JanusErasmus/io_niode/Firmware/readme.md

# IO Node Firmware

## Building it
  - Import this project into [STM32CubeIDE](https://www.st.com/en/development-tools/stm32cubeide.html)
  - Build and load to board using  
    - [stm32flash loader](https://git.code.sf.net/p/stm32flash/code)  
or
    - [STM32CubeProgrammer](https://www.st.com/content/st_com/en/products/development-tools/software-development-tools/stm32-software-development-tools/stm32-programmers/stm32cubeprog.html)
