JanusErasmus/io_niode/Hardware/io_node.kicad_pcb

## KiCad design Hardware/io_node.kicad_pcb (2020-10-30)

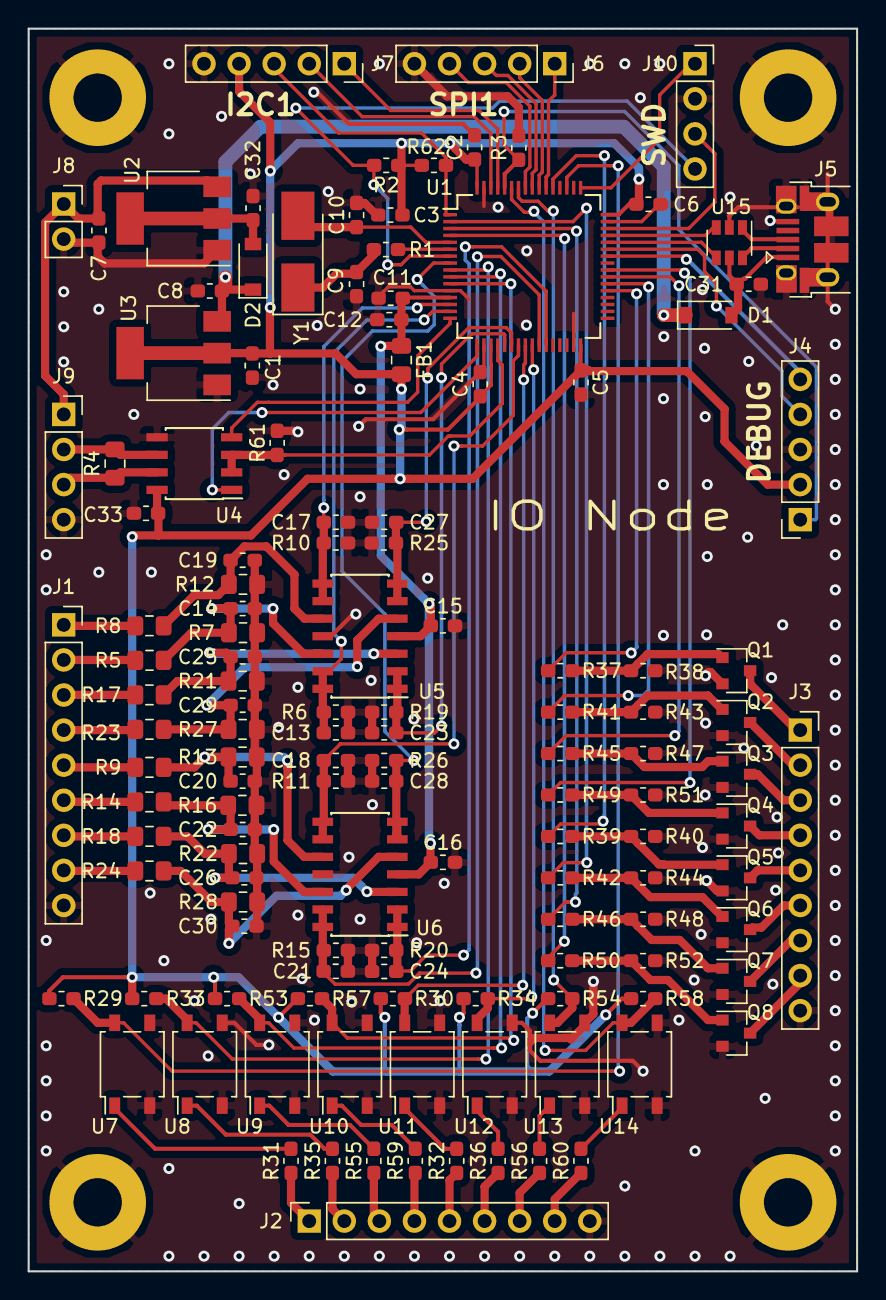
[picture p1: board io_node.kicad_pcb from above]

Board: 2 copper layers, 60.0 x 90.0 mm, 136 parts (0 on the bottom side), 104 nets.

Parts:
C1, C7: 4_7UF; C_0603_1608Metric_Pad1.05x0.95mm_HandSolder
C2, C3, C4, C5, C6, C8, C11, C14, C15, C16, C19, C20, C22, C25, C26, C29, C30, C31, C32, C33: 100NF; C_0603_1608Metric_Pad1.05x0.95mm_HandSolder
C9, C10: 33PF; C_0603_1608Metric_Pad1.05x0.95mm_HandSolder
C12, C13, C17, C18, C21, C23, C24, C27, C28: 1NF; C_0603_1608Metric_Pad1.05x0.95mm_HandSolder
D1, D2: B5819W; D_SOD-123
FB1: 600R; R_0805_2012Metric_Pad1.15x1.40mm_HandSolder
H1, H2, H3, H4: MountingHole_Pad; MountingHole_3.5mm_Pad
J1, J2, J3: Conn_01x09; PinSocket_1x09_P2.54mm_Vertical
J4, J6, J7: Conn_01x05; PinSocket_1x05_P2.54mm_Vertical
J5: USB_B_Micro; USB_Micro-B_Amphenol_10103594-0001LF_Horizontal
J8: Conn_01x02; PinSocket_1x02_P2.54mm_Vertical
J9, J10: Conn_01x04; PinSocket_1x04_P2.54mm_Vertical
Q1, Q2, Q3, Q4, Q5, Q6, Q7, Q8: 2N7002; SOT-23
R1, R31, R32, R35, R36, R55, R56, R59, R60: 470R; R_0603_1608Metric_Pad1.05x0.95mm_HandSolder
R2, R3, R6, R10, R11, R15, R19, R20, R25, R26, R29, R30, R33, R34, R38, R40, R43, R44, R47, R48, R51, R52, R53, R54, R57, R58, R61: 10K; R_0603_1608Metric_Pad1.05x0.95mm_HandSolder
R4: 120R; R_0805_2012Metric_Pad1.15x1.40mm_HandSolder
R5, R7, R8, R9, R12, R13, R14, R16, R17, R18, R21, R22, R23, R24, R27, R28: 10K; R_0805_2012Metric_Pad1.15x1.40mm_HandSolder
R37, R39, R41, R42, R45, R46, R49, R50: 1K; R_0603_1608Metric_Pad1.05x0.95mm_HandSolder
R62: 0R; R_0603_1608Metric_Pad1.05x0.95mm_HandSolder
U1: STM32F103RBT6; LQFP-64_10x10mm_P0.5mm
U2: AMS1117-5.0; SOT-223-3_TabPin2
U3: AMS1117-3.3; SOT-223-3_TabPin2
U4: SP3485EN; SOIC-8_3.9x4.9mm_P1.27mm
U5, U6: LM324DT; SOIC-14_3.9x8.7mm_P1.27mm
U7, U8, U9, U10, U11, U12, U13, U14: EL357N-G; SO-4_4.4x4.3mm_P2.54mm
U15: USBLC6-2SC6; SOT-23-6
Y1: 8 MHz; Crystal_SMD_5032-2Pin_5.0x3.2mm_HandSoldering

Connections:
+3.3VA: C11.1, C12.1, C15.1, C16.1, FB1.1, U1.13, U5.4, U6.4
+3V3: C1.1, C2.1, C3.1, C4.1, C5.1, C6.1, C33.1, FB1.2, J4.2, J7.4, R2.1, R29.1, R30.1, R33.1, R34.1, R53.1, R54.1, R57.1, R58.1, R62.2, U1.19, U1.32, U1.48, U1.64, U3.2, U4.8
+5V: C8.1, D1.1, D2.1, U3.3
+12V: C7.1, J8.1, J9.1, U2.3
+BATT: J7.3, R62.1, U1.1
/ADC_IN0: C17.1, R10.1, U1.14, U5.8, U5.9
/ADC_IN1: C13.1, R6.1, U1.15, U5.13, U5.14
/ADC_IN5: C23.1, R19.1, U1.21, U5.1, U5.2
/ADC_IN6: C27.1, R25.1, U1.22, U5.6, U5.7
/ADC_IN7: C18.1, R11.1, U1.23, U6.8, U6.9
/ADC_IN8: C21.1, R15.1, U1.26, U6.13, U6.14
/ADC_IN9: C24.1, R20.1, U1.27, U6.1, U6.2
/ADC_IN10: C28.1, R26.1, U1.8, U6.6, U6.7
/Analog/AIN_0: J1.1, R8.1
/Analog/AIN_1: J1.2, R5.1
/Analog/AIN_2: J1.3, R17.1
/Analog/AIN_3: J1.4, R23.1
/Analog/AIN_4: J1.5, R9.1
/Analog/AIN_5: J1.6, R14.1
/Analog/AIN_6: J1.7, R18.1
/Analog/AIN_7: J1.8, R24.1
/BOOT0: J4.1, R3.1, U1.60
/I2C1_SCL: J7.1, U1.61
/I2C1_SDA: J7.2, U1.62
/IN_0: R29.2, U1.51, U7.4
/IN_1: R33.2, U1.9, U8.4
/IN_2: R53.2, U1.10, U9.4
/IN_3: R57.2, U1.11, U10.4
/IN_4: R30.2, U1.24, U11.4
/IN_5: R34.2, U1.25, U12.4
/IN_6: R54.2, U1.58, U13.4
/IN_7: R58.2, U1.59, U14.4
/Input/DIN_0: J2.1, R31.1
/Input/DIN_1: J2.2, R35.1
/Input/DIN_2: J2.3, R55.1
/Input/DIN_3: J2.4, R59.1
/Input/DIN_4: J2.5, R32.1
/Input/DIN_5: J2.6, R36.1
/Input/DIN_6: J2.7, R56.1
/Input/DIN_7: J2.8, R60.1
/NRST: J10.4, R2.2, U1.7
/OUT_4: R39.1, U1.53
/OUT_5: R42.1, U1.2
/OUT_6: R46.1, U1.3
/OUT_7: R50.1, U1.4
/Output/DOT_0: J3.1, Q1.3
/Output/DOT_1: J3.2, Q2.3
/Output/DOT_2: J3.3, Q3.3
/Output/DOT_3: J3.4, Q4.3
/Output/DOT_4: J3.5, Q5.3
/Output/DOT_5: J3.6, Q6.3
/Output/DOT_6: J3.7, Q7.3
/Output/DOT_7: J3.8, Q8.3
/RS485_A: J9.2, R4.2, U4.6
/RS485_B: J9.3, R4.1, U4.7
/SPI1_CS: J6.1, U1.54
/SPI1_MISO: J6.3, U1.56
/SPI1_MOSI: J6.4, U1.57
/SPI1_SCK: J6.2, U1.55
/SWCLK: J10.1, U1.49
/SWDIO: J10.3, U1.46
/TIM3_CH1: R37.1, U1.37
/TIM3_CH2: R41.1, U1.38
/TIM3_CH3: R45.1, U1.39
/TIM3_CH4: R49.1, U1.40
/USART1_RX: J4.4, U1.43
/USART1_TX: J4.5, U1.42
/USART2_DE: R61.1, U1.20, U4.2, U4.3
/USART2_RX: U1.17, U4.1
/USART2_TX: U1.16, U4.4
/USB_CONN_DM: J5.2, U15.6
/USB_CONN_DP: J5.3, U15.1
/USB_N: U1.44, U15.4
/USB_P: U1.45, U15.3
GND: C1.2, C2.2, C3.2, C4.2, C5.2, C6.2, C7.2, C8.2, C9.2, C10.2, C11.2, C12.2, C13.2, C14.2, C15.2, C16.2, C17.2, C18.2, C19.2, C20.2, C21.2, C22.2, C23.2, C24.2, C25.2, C26.2, C27.2, C28.2, C29.2, C30.2, C31.2, C32.2, C33.2, H1.1, H2.1, H3.1, H4.1, J1.9, J2.9, J3.9, J4.3, J5.5, J5.6, J6.5, J7.5, J8.2, J9.4, J10.2, Q1.2, Q2.2, Q3.2, Q4.2, Q5.2, Q6.2, Q7.2, Q8.2, R3.2, R6.2, R7.2, R10.2, R11.2, R12.2, R13.2, R15.2, R16.2, R19.2, R20.2, R21.2, R22.2, R25.2, R26.2, R27.2, R28.2, R38.2, R40.2, R43.2, R44.2, R47.2, R48.2, R51.2, R52.2, R61.2, U1.12, U1.18, U1.31, U1.47, U1.63, U2.1, U3.1, U4.5, U5.11, U6.11, U7.2, U7.3, U8.2, U8.3, U9.2, U9.3, U10.2, U10.3, U11.2, U11.3, U12.2, U12.3, U13.2, U13.3, U14.2, U14.3, U15.2
unnamed: C9.1, R1.2, Y1.1
unnamed: C10.1, U1.5, Y1.2
unnamed: C14.1, R5.2, R7.1, U5.12
unnamed: C19.1, R8.2, R12.1, U5.10
unnamed: C20.1, R9.2, R13.1, U6.10
unnamed: C22.1, R14.2, R16.1, U6.12
unnamed: C25.1, R17.2, R21.1, U5.3
unnamed: C26.1, R18.2, R22.1, U6.3
unnamed: C29.1, R23.2, R27.1, U5.5
unnamed: C30.1, R24.2, R28.1, U6.5
unnamed: C32.1, D2.2, U2.2
unnamed: Q1.1, R37.2, R38.1
unnamed: Q2.1, R41.2, R43.1
unnamed: Q3.1, R45.2, R47.1
unnamed: Q4.1, R49.2, R51.1
unnamed: Q5.1, R39.2, R40.1
unnamed: Q6.1, R42.2, R44.1
unnamed: Q7.1, R46.2, R48.1
unnamed: Q8.1, R50.2, R52.1
unnamed: R1.1, U1.6
unnamed: R31.2, U7.1
unnamed: R32.2, U11.1
unnamed: R35.2, U8.1
unnamed: R36.2, U12.1
unnamed: R55.2, U9.1
unnamed: R56.2, U13.1
unnamed: R59.2, U10.1
unnamed: R60.2, U14.1
VBUS: C31.1, D1.2, J5.1, U15.5
