JanusErasmus/io_niode/Firmware/Core/Src/main.c

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
/* Includes ------------------------------------------------------------------*/
#include "main.h"
#include "adc.h"
#include "i2c.h"
#include "rtc.h"
#include "spi.h"
#include "usart.h"
#include "gpio.h"

/* USER CODE BEGIN Includes */
#include <stdio.h>
#include <stdlib.h>
#include <string.h>
#include "Utils/cli.h"
#include "stm32f1xx_it.h"
#include "wrap_cpp.h"
#include "ssd1306.h"
#include "dsb18b20.h"
/* USER CODE END Includes */


void SystemClock_Config(void);
/* USER CODE BEGIN 0 */
void tx_usart2(uint8_t *data, int len)
{
	HAL_GPIO_WritePin(USART2_DE_GPIO_Port, USART2_DE_Pin, GPIO_PIN_SET);
	for (int k = 0; k < len; ++k)
	{
		if(HAL_UART_Transmit(&huart2, data, len, 100) != HAL_OK)
		{
			printf("Could not transmit USART2\n");
			break;
		}
	}
	HAL_GPIO_WritePin(USART2_DE_GPIO_Port, USART2_DE_Pin, GPIO_PIN_RESET);
}

/* USER CODE END 0 */

/**
  * @brief  The application entry point.
  * @retval int
  */
int main(void)
{
  /* MCU Configuration--------------------------------------------------------*/

  /* Reset of all peripherals, Initializes the Flash interface and the Systick. */
  HAL_Init();

  /* Configure the system clock */
  SystemClock_Config();

  /* Initialize all configured peripherals */
  MX_GPIO_Init();
  MX_USART1_UART_Init();
  MX_ADC1_Init();
  MX_USART2_UART_Init();
  MX_RTC_Init();
  MX_SPI1_Init();
  /* Infinite loop */
  /* USER CODE BEGIN WHILE */
  printf("IO Node\n");
  printf("SYSCLOCK: %lu Hz\n", HAL_RCC_GetSysClockFreq());
  printf("HCLOCK  : %lu Hz\n", HAL_RCC_GetHCLKFreq());
  printf("APB1    : %lu Hz\n", HAL_RCC_GetPCLK1Freq());
  printf("APB2    : %lu Hz\n", HAL_RCC_GetPCLK2Freq());

  setbuf(stdout, NULL);
  cli_init("io$ ");
  cpp_init();

  USART1->CR1 |= USART_CR1_RXNEIE;
  USART1->CR3 |= USART_CR3_EIE;

  USART2->CR1 |= USART_CR1_RXNEIE;
  USART2->CR3 |= USART_CR3_EIE;

  uint32_t sample_tick = HAL_GetTick() + 2000;
  uint32_t tick =  HAL_GetTick();
  while (1)
  {
      cli_run();
      cpp_run();
      /* USER CODE END WHILE */

      /* USER CODE BEGIN 3 */
      if(tick < HAL_GetTick())
      {
          tick = HAL_GetTick() + 100;

          char data[64];
          int rx = usart2_pop((uint8_t*)data, 64);
          if(rx)
          {
              for (int k = 0; k < rx; ++k)
              {
                  printf("RX %02X\n", data[k]);
              }
          }

          if(sample_tick < HAL_GetTick())
          {
              //report every 10 min
              sample_tick = HAL_GetTick() + 600000;
              cpp_report(1);
          }
      }
  }

  /* USER CODE END 3 */
}

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
/* USER CODE BEGIN 4 */

#ifdef __GNUC__
/* With GCC/RAISONANCE, small printf (option LD Linker->Libraries->Small printf
 set to 'Yes') calls __io_putchar() */
#define PUTCHAR_PROTOTYPE int __io_putchar(int ch)
#else
#define PUTCHAR_PROTOTYPE int fputc(int ch, FILE *f)
#endif /* __GNUC__ */

/**
 * @brief Retargets the C library printf function to the USART.
 * @param None
 * @retval None
 */
PUTCHAR_PROTOTYPE
{
  if(ch == '\n')
  {
    uint8_t cr = '\r';
    HAL_UART_Transmit(&huart1, &cr, 1, 0xFFFF);
  }

//  if(ch == '\r')
//  {
//    uint8_t cr = '\n';
//    HAL_UART_Transmit(&huart1, &cr, 1, 0xFFFF);
//  }


 HAL_UART_Transmit(&huart1, (uint8_t *)&ch, 1, 0xFFFF);

return ch;
}
/* USER CODE END 4 */
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
