JanusErasmus/io_niode/Firmware/Core/Inc/main.h

#define OUT_5_Pin GPIO_PIN_13
#define OUT_5_GPIO_Port GPIOC
#define OUT_6_Pin GPIO_PIN_14
#define OUT_6_GPIO_Port GPIOC
#define OUT_7_Pin GPIO_PIN_15
#define OUT_7_GPIO_Port GPIOC
#define IN_1_Pin GPIO_PIN_1
#define IN_1_GPIO_Port GPIOC
#define IN_2_Pin GPIO_PIN_2
#define IN_2_GPIO_Port GPIOC
#define IN_3_Pin GPIO_PIN_3
#define IN_3_GPIO_Port GPIOC
#define USART2_DE_Pin GPIO_PIN_4
#define USART2_DE_GPIO_Port GPIOA
#define IN_4_Pin GPIO_PIN_4
#define IN_4_GPIO_Port GPIOC
#define IN_5_Pin GPIO_PIN_5
#define IN_5_GPIO_Port GPIOC
#define OUT_0_Pin GPIO_PIN_6
#define OUT_0_GPIO_Port GPIOC
#define OUT_1_Pin GPIO_PIN_7
#define OUT_1_GPIO_Port GPIOC
#define OUT_2_Pin GPIO_PIN_8
#define OUT_2_GPIO_Port GPIOC
#define OUT_3_Pin GPIO_PIN_9
#define OUT_3_GPIO_Port GPIOC
#define NRF_CE_Pin GPIO_PIN_13
#define NRF_CE_GPIO_Port GPIOA
#define NRF_IRQ_Pin GPIO_PIN_14
#define NRF_IRQ_GPIO_Port GPIOA
#define IN_0_Pin GPIO_PIN_10
#define IN_0_GPIO_Port GPIOC
#define OUT_4_Pin GPIO_PIN_12
#define OUT_4_GPIO_Port GPIOC
#define SPI1_CS_Pin GPIO_PIN_2
#define SPI1_CS_GPIO_Port GPIOD
#define IN_6_Pin GPIO_PIN_6
#define IN_6_GPIO_Port GPIOB
#define IN_7_Pin GPIO_PIN_7
#define IN_7_GPIO_Port GPIOB
