JanusErasmus/io_niode/Firmware/Core/Src/interface_nrf24.cpp

/*
 * interface_nrf24.cpp
 *
 *  Created on: 14 Jul 2018
 *      Author: janus
 */
#include <stdio.h>
#include <string.h>

#include "main.h"
#include "Utils/utils.h"
#include "interface_nrf24.h"

InterfaceNRF24 *InterfaceNRF24::__instance = 0;

SPI_HandleTypeDef *InterfaceNRF24::mSPI = 0;

uint8_t InterfaceNRF24::nrf_t(uint8_t *tx_data, uint8_t *rx_data, int len)
{
	if(!mSPI)
		return 0;

	HAL_SPI_TransmitReceive(mSPI, tx_data, rx_data, len, 1000);

	return len;
}

void InterfaceNRF24::nrf_cs_l(void)
{
	HAL_GPIO_WritePin(SPI1_CS_GPIO_Port, SPI1_CS_Pin, GPIO_PIN_RESET);
}

void InterfaceNRF24::nrf_cs_h(void)
{
	HAL_GPIO_WritePin(SPI1_CS_GPIO_Port, SPI1_CS_Pin, GPIO_PIN_SET);
}

void InterfaceNRF24::nrf_ce_l(void)
{
	HAL_GPIO_WritePin(NRF_CE_GPIO_Port, NRF_CE_Pin, GPIO_PIN_RESET);
}

void InterfaceNRF24::nrf_ce_h(void)
{
	HAL_GPIO_WritePin(NRF_CE_GPIO_Port, NRF_CE_Pin, GPIO_PIN_SET);
}

void InterfaceNRF24::init(SPI_HandleTypeDef *spi_handle, uint8_t *net_address, int len)
{
	if(!__instance)
		__instance = new InterfaceNRF24(spi_handle, net_address, len);
}

void addrToString(uint8_t *addr, char *string, int len)
{
	for (int k = 0; k < len; ++k)
	{
		sprintf(string, "%02X", addr[k]);
		string += 2;

		if(k < (len - 1))
			sprintf(string++, ":");
	}
}

void printPipe(uint8_t pipe)
{
	char pipeStr[16];
	uint8_t pipeAddr[8];
	int len = nRF24_GetAddr(pipe, pipeAddr);
	addrToString(pipeAddr, pipeStr, len);

	if(pipe < nRF24_PIPETX)
		printf("PIPE%2d %s\n", pipe, pipeStr);
	else
		printf("PIPETX %s\n", pipeStr);
}

void printPipes()
{
	for (int k = 0; k < 7; ++k)
	{
		printPipe(k);
	}
}

InterfaceNRF24::InterfaceNRF24(SPI_HandleTypeDef *spi_handle, uint8_t *net_addr, int len)
{
	mPacketsLost = 0;
	mSPI = spi_handle;

	memcpy(mNetAddress, net_addr, 8);

	nrf_cb.nRF24_T = nrf_t;
	nrf_cb.nRF24_CSN_L = nrf_cs_l;
	nrf_cb.nRF24_CSN_H = nrf_cs_h;
	nrf_cb.nRF24_CE_L = nrf_ce_l;
	nrf_cb.nRF24_CE_H = nrf_ce_h;

	nRF24_Init(&nrf_cb);

	// Set RF channel
	nRF24_SetRFChannel(84);
	printf("NRF @ %dMHz\n", 2400 + 84);

	// Set data rate
	nRF24_SetDataRate(nRF24_DR_250kbps);

	// Set CRC scheme
	nRF24_SetCRCScheme(nRF24_CRC_2byte);

	// Set address width, its common for all pipes (RX and TX)
	nRF24_SetAddrWidth(3);

	// Configure RX PIPES
	nRF24_SetAddr(nRF24_PIPE0, net_addr);
	nRF24_SetRXPipe(nRF24_PIPE0	, nRF24_AA_OFF, 32);

	// Set TX power for Auto-ACK (maximum, to ensure that transmitter will hear ACK reply)
	nRF24_SetTXPower(nRF24_TXPWR_0dBm);

	// Configure auto retransmit: 10 retransmissions with pause of 2500s in between
	nRF24_SetAutoRetr(nRF24_ARD_4000us, 10);

	printPipes();

	// Set operational mode (PRX == receiver)
	nRF24_SetOperationalMode(nRF24_MODE_RX);

	// Clear any pending IRQ flags
	nRF24_ClearIRQFlags();

	// Wake the transceiver
	nRF24_SetPowerMode(nRF24_PWR_UP);

	// Put the transceiver to the RX mode
	nrf_ce_h();
}

InterfaceNRF24::~InterfaceNRF24()
{
}

#define nRF24_WAIT_TIMEOUT         (uint32_t)20
// Function to transmit data packet
// input:
//   pBuf - pointer to the buffer with data to transmit
//   length - length of the data buffer in bytes
// return: one of nRF24_TX_xx values
nRF24_TXResult InterfaceNRF24::transmitPacket(uint8_t *pBuf, uint8_t length)
{
	volatile uint32_t wait = nRF24_WAIT_TIMEOUT;
	uint8_t status;

	// Deassert the CE pin (in case if it still high)
	nrf_ce_l();
	HAL_Delay(1);

	// Transfer a data from the specified buffer to the TX FIFO
	nRF24_WritePayload(pBuf, length);
	HAL_Delay(100);

	// Start a transmission by asserting CE pin (must be held at least 10us)
	nrf_ce_h();
	HAL_Delay(1);

	// Poll the transceiver status register until one of the following flags will be set:
	//   TX_DS  - means the packet has been transmitted
	//   MAX_RT - means the maximum number of TX retransmits happened
	// note: this solution is far from perfect, better to use IRQ instead of polling the status
	do {
		status = nRF24_GetStatus();
		if (status & (nRF24_FLAG_TX_DS | nRF24_FLAG_MAX_RT)) {
			break;
		}

		HAL_Delay(100);
	} while (wait--);

	if (!wait) {
		// Timeout
		return nRF24_TX_TIMEOUT;
	}

	// Check the flags in STATUS register
	//printf(" - Status: %02X\n", status);

	if (status & nRF24_FLAG_MAX_RT) {
		// Auto retransmit counter exceeds the programmed maximum limit (FIFO is not removed)
		nRF24_FlushTX();
		return nRF24_TX_MAXRT;
	}

	if (status & nRF24_FLAG_TX_DS) {
		// Successful transmission
		return nRF24_TX_SUCCESS;
	}

	// Some banana happens, a payload remains in the TX FIFO, flush it
	nRF24_FlushTX();

	return nRF24_TX_ERROR;
}


int InterfaceNRF24::transmit(uint8_t *addr, uint8_t *payload, uint8_t length)
{
	int  tx_length = 0;

    // Configure TX PIPE
    nRF24_SetAddr(nRF24_PIPETX, addr); // program TX address

    printf("InterfaceNRF24: TX[0x%02X] %d: \n", addr[0], length);

	//printf("TX  : %d\n", (int)length);
	//diag_dump_buf(payload, length);

	// Transmit a packet
	nRF24_SetOperationalMode(nRF24_MODE_TX);

	nRF24_TXResult tx_res = transmitPacket(payload, length);
	uint8_t otx = nRF24_GetRetransmitCounters();
	uint8_t otx_plos_cnt = (otx & nRF24_MASK_PLOS_CNT) >> 4; // packets lost counter
	//uint8_t otx_arc_cnt  = (otx & nRF24_MASK_ARC_CNT); // auto retransmissions counter
	switch (tx_res) {
	case nRF24_TX_SUCCESS:
		printf(GREEN(" - OK\n"));
		tx_length = length;
		break;
	case nRF24_TX_TIMEOUT:
		printf(RED("TIMEOUT\n"));
		mPacketsLost++;
		tx_length = -1;
		break;
	case nRF24_TX_MAXRT:
		printf(CYAN("MAX RETRANSMIT\n"));
		mPacketsLost += otx_plos_cnt;
		nRF24_ResetPLOS();
		tx_length = -2;
		break;
	default:
		printf(RED("ERROR\n"));
		tx_length = -3;
		break;
	}
	//printf(" - ARC= %d LOST= %d\n", (int)otx_arc_cnt, (int)mPacketsLost);

	//	// Clear pending IRQ flags
	nRF24_ClearIRQFlags();
	nRF24_GetStatus();

    HAL_Delay(100);
    nRF24_SetAddr(nRF24_PIPE0, mNetAddress); // program RX address
    HAL_Delay(100);

	// Set operational mode (PRX == receiver)
	nRF24_SetOperationalMode(nRF24_MODE_RX);

	return tx_length;
}

void InterfaceNRF24::run()
{
	if(HAL_GPIO_ReadPin(NRF_IRQ_GPIO_Port, NRF_IRQ_Pin))
		return;

	uint8_t payload_length = 16;
	uint8_t nRF24_payload[32];
	while (nRF24_GetStatus_RXFIFO() != nRF24_STATUS_RXFIFO_EMPTY) {
		// Get a payload from the transceiver
		nRF24_RXResult pipe = nRF24_ReadPayload(nRF24_payload, &payload_length);

		// Clear all pending IRQ flags
		nRF24_ClearIRQFlags();

		if(receivedCB)
			receivedCB(pipe, nRF24_payload, payload_length);

		//printf("RCV PIPE# %d", (int)pipe);
		//printf(" PAYLOAD:> %d", payload_length);
		//diag_dump_buf(nRF24_payload, payload_length);
	}
}
