JanusErasmus/io_niode/Firmware/Core/Src/wrap_cpp.cpp

/*
 * wrap_cpp.cpp
 *
 *  Created on: Oct 31, 2020
 *      Author: jcera
 */
#include <string.h>
#include <stdio.h>

#include "Utils/crc.h"
#include "Utils/utils.h"
#include "main.h"
#include "interface_nrf24.h"
#include "adc.h"
#include "dsb18b20.h"

extern "C" SPI_HandleTypeDef hspi1;
extern "C" RTC_HandleTypeDef hrtc;

#define STREET_NODE_ADDRESS     0x002564
#define UPS_NODE_ADDRESS        0x01
#define UPS12V_NODE_ADDRESS     0x02
#define FERMENTER_NODE_ADDRESS  0x03
#define HOUSE_NODE_ADDRESS      0x04
#define GARAGE_NODE_ADDRESS     0x05
#define WATER_NODE_ADDRESS      0x06
#define CLOCK_NODE_ADDRESS      0x07
#define KITCHEN_NODE_ADDRESS    0x08
#define IO_NODE_ADDRESS         0x0B

#define NODE_ADDRESS IO_NODE_ADDRESS
#define MINIMUM_REPORT_RATE 600000// 1800000

static uint8_t netAddress[] = {0x23, 0x1B, 0x25};
static uint8_t serverAddress[] = {0x12, 0x3B, 0x45};
static bool reportToServer = false;

enum nodeFrameType_e
{
    DATA = 0,
    COMMAND = 1,
    ACKNOWLEDGE = 2
};

//Node send 32 bytes of data, with the last byte being the 8-bit CRC
typedef struct {
    uint8_t nodeAddress;    //1
    uint8_t frameType;      //1
    uint32_t timestamp;     //4  6
    uint8_t inputs;         //1  7
    uint8_t outputs;        //1  8
    int16_t voltages[4];    //8  16
    int16_t temperature;    //2  18
    uint8_t reserved[13];   //13 31
    uint8_t crc;            //1  32
}__attribute__((packed, aligned(4))) nodeData_s;


void report(uint8_t *address, bool sample)
{
//  //Report 60 seconds apart
//  if(lastReport)
//  {
//      if((lastReport + 60000) > HAL_GetTick())
//          return;
//  }
//  lastReport = HAL_GetTick();

    nodeData_s pay;
    memset(&pay, 0, 32);
    float voltages[8] = {0};
    if(adc_sample(voltages) == HAL_OK)
    {
        pay.temperature = ((voltages[0] * 100.0) - 273.0) * 1000.0;
        printf("T: %d\n", pay.temperature);
        pay.voltages[0] = DS18B20_sample(1) * 1000;
        pay.voltages[1] = voltages[2] * 1000;
        pay.voltages[2] = voltages[3] * 1000;
        pay.voltages[3] = voltages[4] * 1000;
    }
    else
    {
        printf(RED("Could not sample\n"));
    }


    pay.nodeAddress = NODE_ADDRESS;
    pay.timestamp = HAL_GetTick();

    if(sample)
        pay.inputs |= 0x02;

    pay.crc = CRC_8::crc((uint8_t*)&pay, 31);

//    printf("TX: %d\n", 32);
//    diag_dump_buf(&pay, 32);

    //report status in voltages[0-1]
    printf("TX result %d\n", InterfaceNRF24::get()->transmit(address, (uint8_t*)&pay, 32));
}

void reportNow(bool sample)
{
    report(serverAddress, sample);
}

bool NRFreceivedCB(int pipe, uint8_t *data, int len)
{
    if(pipe != 0)
    {
        printf(RED("%d NOT correct pipe\n"), pipe);
        return false;
    }

    if(CRC_8::crc(data, 32))
    {
        printf(RED("CRC error\n"));
        return false;
    }

    bool reportNow = false;
    nodeData_s down;
    memcpy(&down, data, len);
    printf("NRF RX [0x%02X]\n", down.nodeAddress);

    //Check of this is not my data
    if(down.nodeAddress != NODE_ADDRESS)
    {
        if(down.nodeAddress == 0xFF)
        {
            reportNow = true;
        }
        else
            return false;
    }

    if(down.frameType == ACKNOWLEDGE)
    {
        printf("Main: " GREEN("ACK\n"));
        return false;
    }

    printf("RCV Type# %d\n", (int)down.frameType);
    //printf(" PAYLOAD: %d\n", len);
    //diag_dump_buf(data, len);

    int hour = (down.timestamp >> 8) & 0xFF;
    int min = (down.timestamp) & 0xFF;
    printf("Set time %d:%d\n", hour, min);

    RTC_TimeTypeDef sTime;
    sTime.Hours = hour;
    sTime.Minutes = min;
    sTime.Seconds = 0;
    HAL_StatusTypeDef result = HAL_RTC_SetTime(&hrtc, &sTime, RTC_FORMAT_BIN);
    if(result != HAL_OK)
        printf("Could not set Time!!! %d\n", result);


    int month = (down.timestamp >> 24) & 0xFF;
    int day = (down.timestamp >> 16) & 0xFF;
    printf("Set date %d:%d\n", month, day);

    RTC_DateTypeDef sDate;
    HAL_RTC_GetDate(&hrtc, &sDate, RTC_FORMAT_BIN);
    sDate.Month = month;
    sDate.Date = day;
    result = HAL_RTC_SetDate(&hrtc, &sDate, RTC_FORMAT_BIN);
    if(result != HAL_OK)
        printf("Could not set Date!!! %d\n", result);

    //Broadcast pipe
    if(reportNow)
    {
        reportToServer = true;
    }

    //command to node
    if(down.frameType == COMMAND)
    {
        printf("Set Outputs %d\n", down.outputs);

    }

    return false;
}


static void make_output()
{
//    GPIO_InitTypeDef GPIO_InitStruct = {0};
//    GPIO_InitStruct.Pin = IN_7_Pin;
//    GPIO_InitStruct.Mode = GPIO_MODE_OUTPUT_OD;
//    GPIO_InitStruct.Pull = GPIO_NOPULL;
//    GPIO_InitStruct.Speed = GPIO_SPEED_FREQ_HIGH;
//    HAL_GPIO_Init(GPIOB, &GPIO_InitStruct);

    // Streamlined configuration for PB07 as output OD
    // Set MODE7 = 0x03 (50 MHz Output) , CNF7 = 0x01 (open drain)
    GPIOB->CRL |= 0x03 << 28 ;
}

static void make_input()
{
//    GPIO_InitTypeDef GPIO_InitStruct = {0};
//    GPIO_InitStruct.Pin = IN_7_Pin;
//    GPIO_InitStruct.Mode = GPIO_MODE_INPUT;
//    GPIO_InitStruct.Pull = GPIO_NOPULL;
//    GPIO_InitStruct.Speed = GPIO_SPEED_FREQ_HIGH;
//    HAL_GPIO_Init(GPIOB, &GPIO_InitStruct);

    //Streamlined configuration for PB07 as input
    // Set MODE7 = 0x00 (Input) , CNF7 = 0x01 (floating input)
    GPIOB->CRL &= ~(0x03 << 28) ;
}

static void init()
{
    InterfaceNRF24::init(&hspi1, netAddress, 3);
    InterfaceNRF24::get()->setRXcb(NRFreceivedCB);

    DS18B20_Init(IN_7_GPIO_Port, IN_7_Pin, make_input, make_output);
}

static void run()
{
    InterfaceNRF24::get()->run();
    if(reportToServer)
    {
        reportToServer = false;

        //before transmitting wait 200 ms intervals of node address
        HAL_Delay(200 + (NODE_ADDRESS * 200));
        reportNow(false);
    }
}

extern "C" {
void cpp_init()
{
    init();
}

void cpp_run()
{
    run();
}

void cpp_report(int sample)
{
    reportNow(sample);
}
}
