JanusErasmus/io_niode/(commit log)

2020-10-01 inital commit
    [io_node.kicad_pcb, io_node.sch]
2020-10-12 Add in and output drivers
    [analog.sch, input.sch, io_node.kicad_pcb, io_node.sch, output.sch]
2020-10-12 Add USB protection
    [analog.sch, input.sch, io_node.kicad_pcb, io_node.sch, output.sch]
2020-10-14 Add power connector
    [analog.sch, input.sch, io_node.kicad_pcb, io_node.sch, output.sch]
2020-10-15 Layout DIN DOT
    [input.sch, io_node.kicad_pcb, io_node.sch, output.sch]
2020-10-16 Add SWD
    [io_node.kicad_pcb, io_node.sch]
2020-10-16 Update USB footprint
    [analog.sch, input.sch, io_node.kicad_pcb, io_node.sch, output.sch]
2020-10-18 Adjust BOM for Node with divider
    [analog.sch, input.sch, io_node.kicad_pcb, io_node.sch, output.sch]
2020-10-18 OP-AMP power was incorrect
    [analog.sch, io_node.kicad_pcb]
2020-10-18 RS485 TX and RX was incorrect
    [io_node.kicad_pcb, io_node.sch]
2020-10-18 Debug RX TX swapped
    [io_node.kicad_pcb, io_node.sch]
2020-10-18 Add Vbat
    [io_node.kicad_pcb, io_node.sch]
2020-10-30 Add ADC sampling
    [io_node.kicad_pcb]
2020-10-30 Disable USB, fix USB protection
    [analog.sch, input.sch, io_node.sch, output.sch]
2020-10-31 Add NRF driver
2020-10-31 ADD SSD1306 display on I2C
2020-12-25 Let Cube HAL handle other interrupts from UART
2021-01-13 Add enclosure design
    [io_node.scad]
2021-01-16 Add DS18B20 temperature sensor [bit bang, DWT(Data watchpoint trigger) us delay]
    [io_node.scad]
2021-01-17 Clean main, sample DS18B20 and send with V[0]
    [io_node.scad]
