JanusErasmus/io_niode/(notices)

Notices in the files:
Firmware/Core/Inc/main.h:
© Copyright (c) 2020 STMicroelectronics.
All rights reserved.
